mustangwayrobots/ESP_NOW_CAR/(commit log)

2026-10-16 added webpage for the repository
    [partitions.csv]
2026-10-21 Rename 2026-10-20 15_32_07-Untitled 1 — LibreOffice Writer.png to pcb-layout.png
2026-10-27 new pin assignment for ver 2 hardware
2026-11-05 Enhance build workflow for auto-detecting boards
    Updated the build workflow to auto-detect board variants and compile for each. Added JSON manifest generation for firmware builds.
2026-11-05 REnamed BOARD to HARDWARE
2026-11-05 Update build script for ESP32-C3 firmware binaries
2026-11-05 Fix workflow to use actions/setup-arduino-cli
2026-11-05 Refactor Arduino CLI setup and build process
    Updated the Arduino CLI setup step and modified the build process to streamline binary handling and manifest creation.
2026-11-05 Update build workflow for Arduino CLI and manifests
2026-11-05 Update Arduino CLI setup and compilation steps
2026-11-05 Update hardware version options and install button
2026-11-06 Update .gitignore for Arduino workspace and outputs
2026-11-08 Rename 2026-11-07 22_05_03-ESP_NOW_Controller - HardwareConfig.h _ Arduino IDE 2.3.10.png to schematic.png
2026-11-08 Rename 2026-11-07 22_05_28-Downloads - File Explorer.png to PCB_Layout.png
2026-11-08 Rename 2026-11-06 09_46_15-ESP_NOW_CAR _ Arduino IDE 2.3.10.png to PCB_Layout.png
2026-11-08 Revise README for ESP NOW CAR project
    Updated project documentation to reflect new project name and details about the ESP NOW CAR. Revised sections on hardware status, bill of materials, and firmware installation.
